eee62/thinpowebank/enclosure/img/c70_v3_front.png

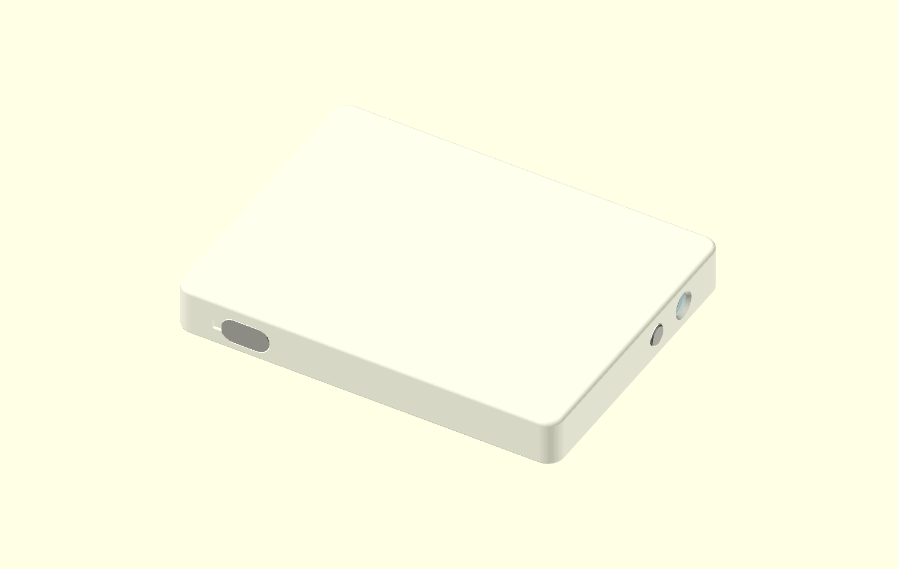
enclosure/img/c70_v3_front.png
