eee62/thinpowebank/enclosure/stl/c70_v3_usb_cover_C.stl

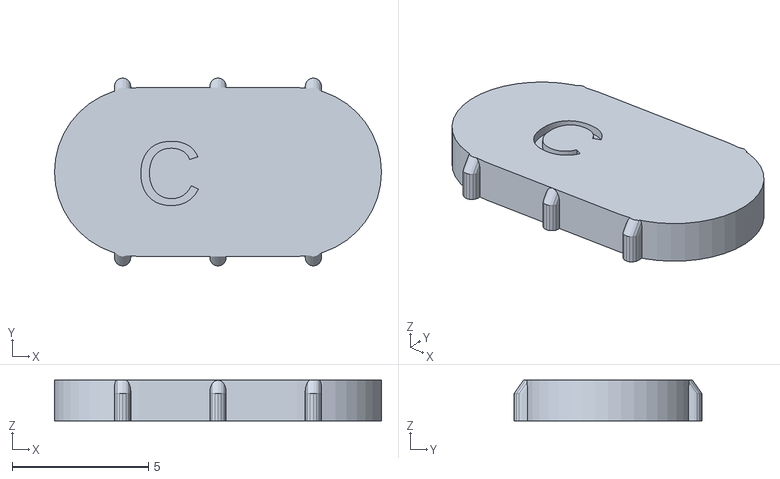
[picture p23: CAD file, 2026-11-07]
enclosure/stl/c70_v3_usb_cover_C.stl
12.0 x 6.90 x 1.50
