eee62/thinpowebank/enclosure/stl/v2/c70_plug_v2_rounded.stl

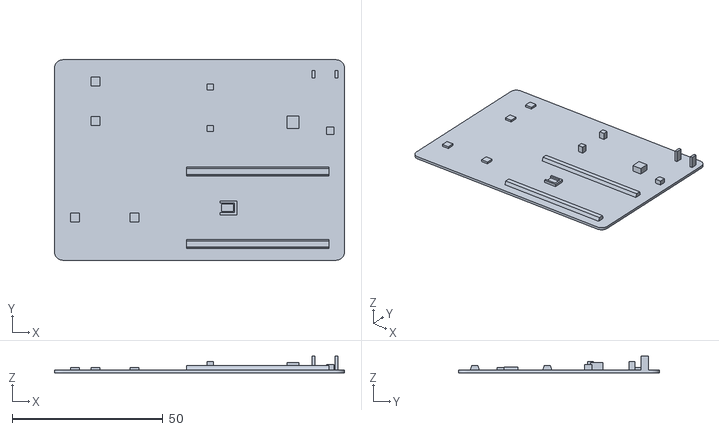
[picture p24: CAD file, 2026-11-06]
enclosure/stl/v2/c70_plug_v2_rounded.stl
96.1 x 66.5 x 5.58
