eee62/thinpowebank/enclosure/stl/c70_v3_plug_v1_sharp_removable.stl

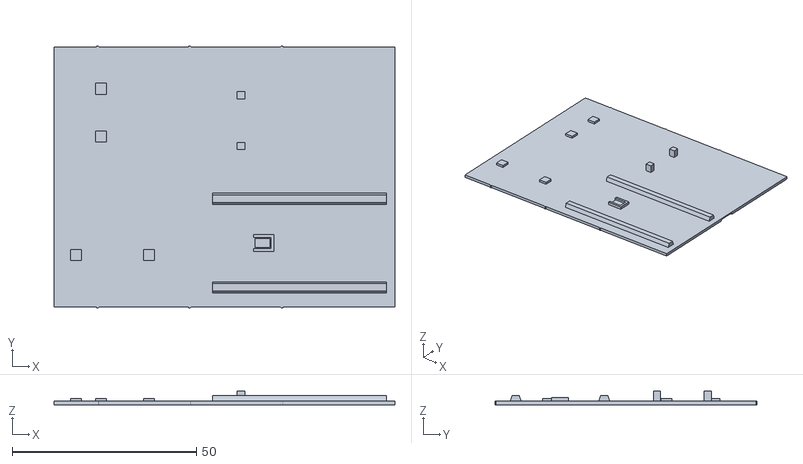
[picture p26: CAD file, 2026-11-07]
enclosure/stl/c70_v3_plug_v1_sharp_removable.stl
92.5 x 71.2 x 3.75
