eee62/thinpowebank/enclosure/stl/v2/c70_wifi_test.stl

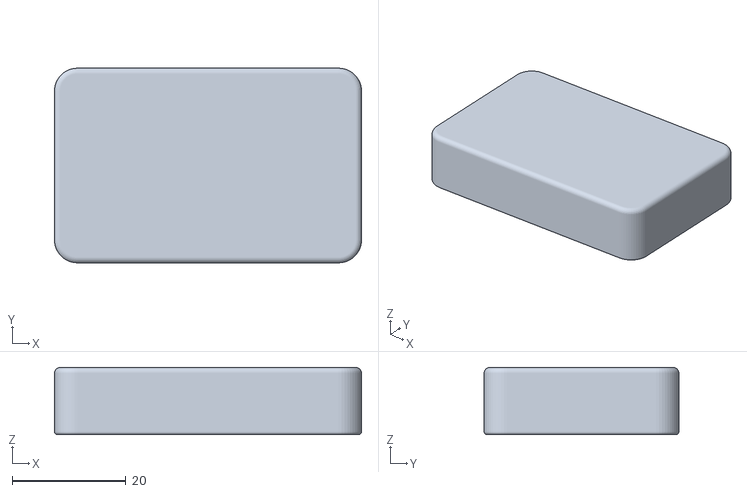
[picture p27: CAD file, 2026-11-06]
enclosure/stl/v2/c70_wifi_test.stl
53.9 x 34.2 x 11.8
