eee62/thinpowebank/enclosure/stl/c70_v3_body_v1_sharp.stl

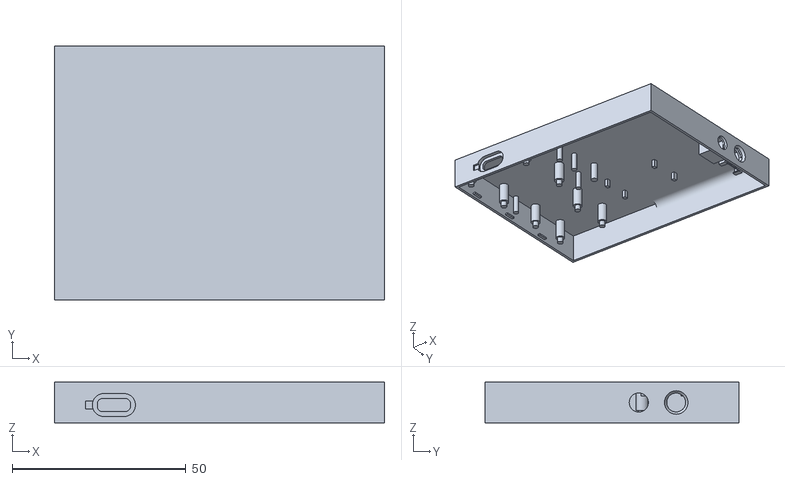
[picture p28: CAD file, 2026-11-07]
enclosure/stl/c70_v3_body_v1_sharp.stl
94.8 x 73.0 x 11.8
