eee62/thinpowebank/enclosure/stl/v2/c70_usb_cover_B.stl

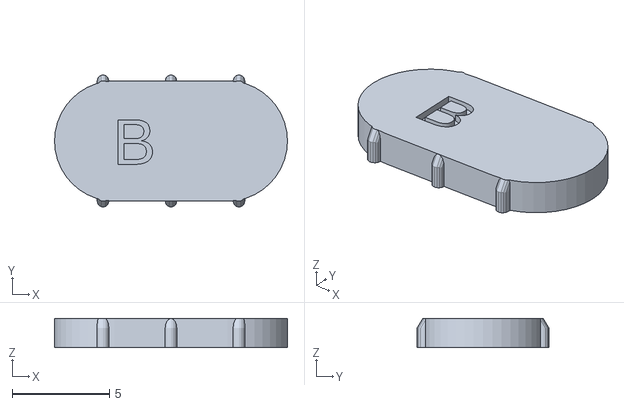
[picture p29: CAD file, 2026-11-06]
enclosure/stl/v2/c70_usb_cover_B.stl
12.0 x 6.80 x 1.50
