eee62/thinpowebank/enclosure/stl/c70_v3_plug_v2_rounded.stl

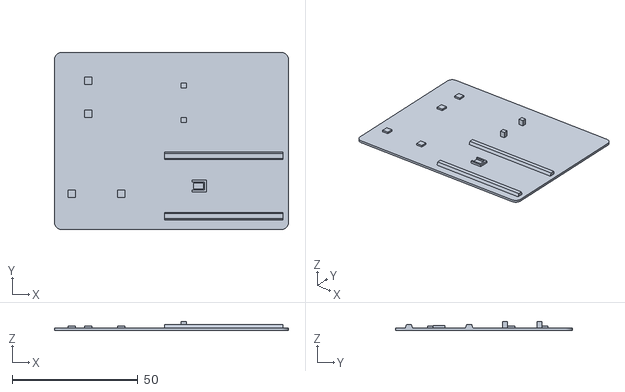
[picture p30: CAD file, 2026-11-07]
enclosure/stl/c70_v3_plug_v2_rounded.stl
93.2 x 70.5 x 3.75
