eee62/thinpowebank/enclosure/stl/v2/c70_wifi_test_plug.stl

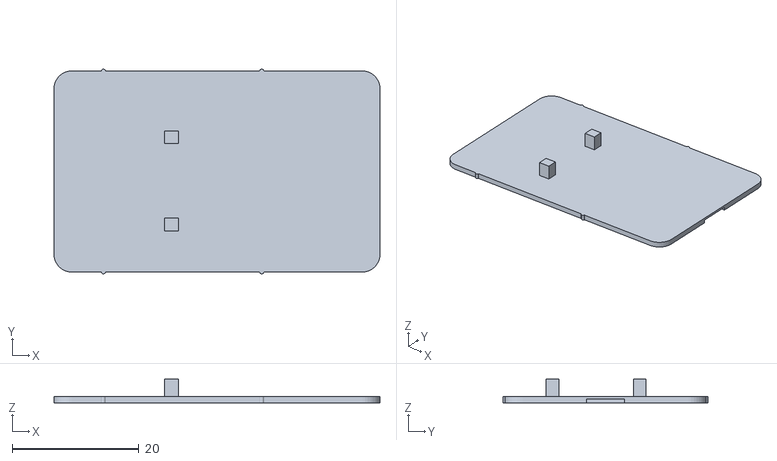
[picture p31: CAD file, 2026-11-06]
enclosure/stl/v2/c70_wifi_test_plug.stl
51.5 x 32.3 x 3.75
