eee62/thinpowebank/enclosure/stl/c70_v3_wifi_test.stl

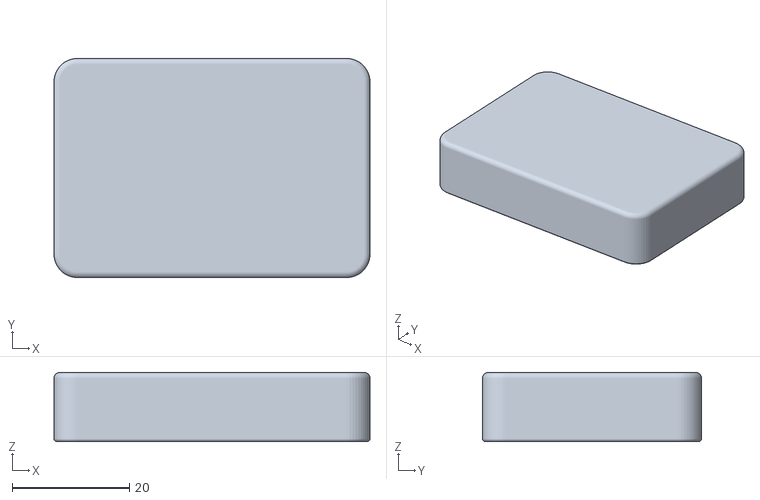
[picture p32: CAD file, 2026-11-07]
enclosure/stl/c70_v3_wifi_test.stl
53.9 x 37.3 x 11.8
