eee62/thinpowebank/enclosure/stl/c70_v3_wifi_test_plug.stl

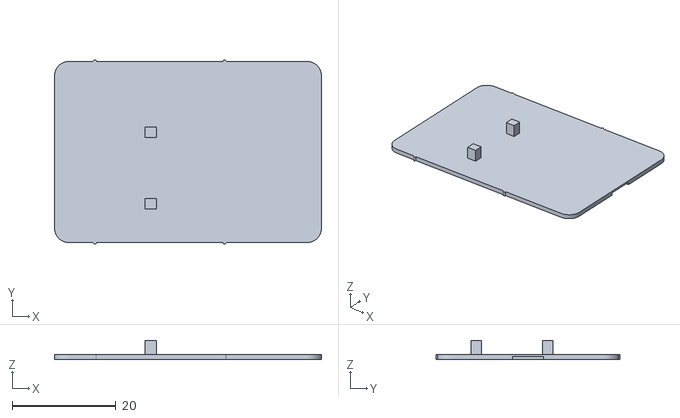
[picture p34: CAD file, 2026-11-07]
enclosure/stl/c70_v3_wifi_test_plug.stl
51.5 x 35.5 x 3.75
