eee62/thinpowebank/enclosure/stl/v2/c70_plug_v1_sharp_removable.stl

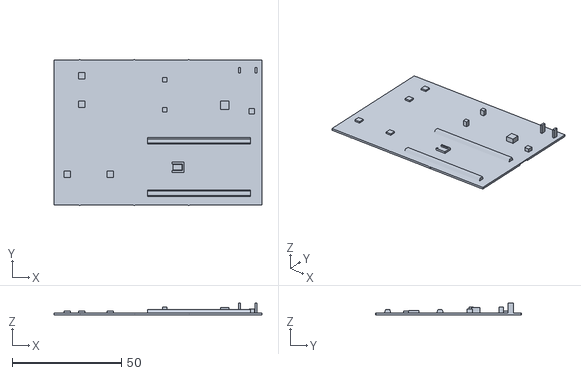
[picture p35: CAD file, 2026-11-06]
enclosure/stl/v2/c70_plug_v1_sharp_removable.stl
95.3 x 67.1 x 5.58
