eee62/thinpowebank/enclosure/stl/c70_v3_body_v2_rounded.stl

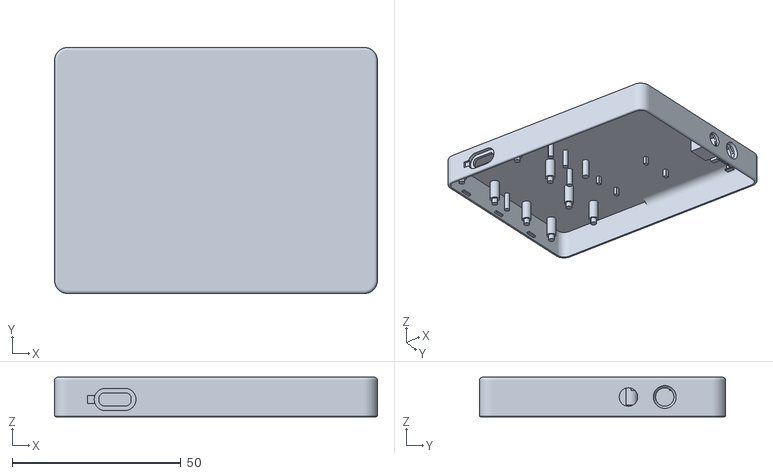
[picture p36: CAD file, 2026-11-07]
enclosure/stl/c70_v3_body_v2_rounded.stl
95.7 x 73.0 x 11.8
