eee62/thinpowebank/enclosure/stl/v2/c70_plug_v1_sharp.stl

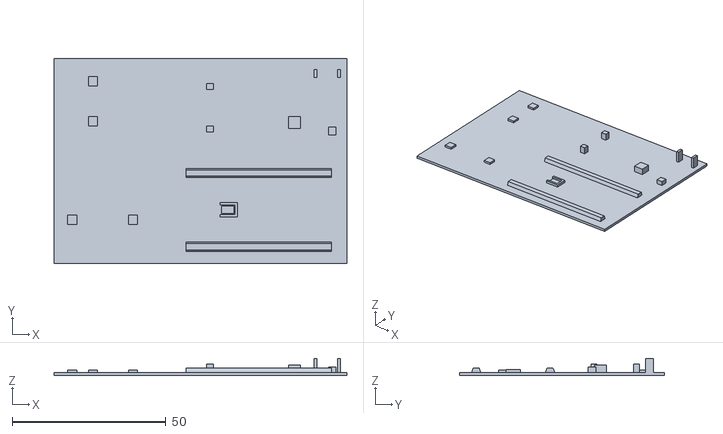
[picture p37: CAD file, 2026-11-06]
enclosure/stl/v2/c70_plug_v1_sharp.stl
95.2 x 66.5 x 5.58
