eee62/thinpowebank/enclosure/stl/c70_v3_button_cap.stl

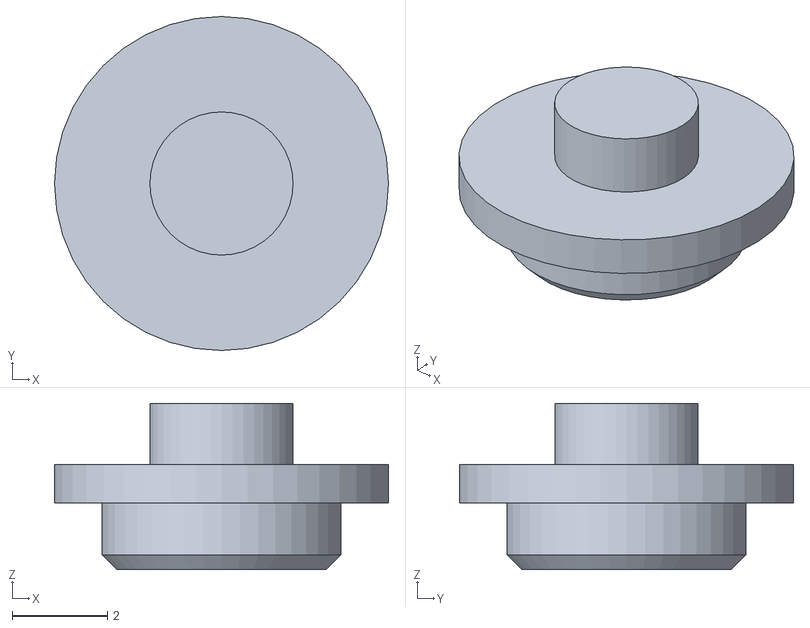
[picture p38: CAD file, 2026-11-07]
enclosure/stl/c70_v3_button_cap.stl
7.00 x 7.00 x 3.48
