eee62/thinpowebank/enclosure/stl/c70_v3_plug_v2_rounded_removable.stl

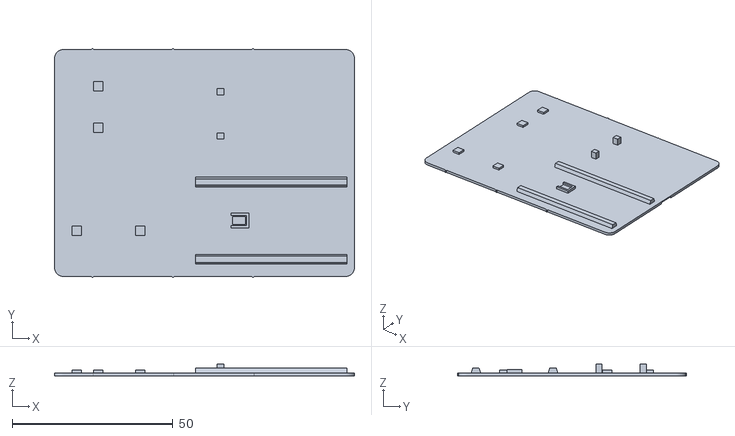
[picture p40: CAD file, 2026-11-07]
enclosure/stl/c70_v3_plug_v2_rounded_removable.stl
93.3 x 71.2 x 3.75
