eee62/thinpowebank/enclosure/stl/v2/c70_usb_cover_A.stl

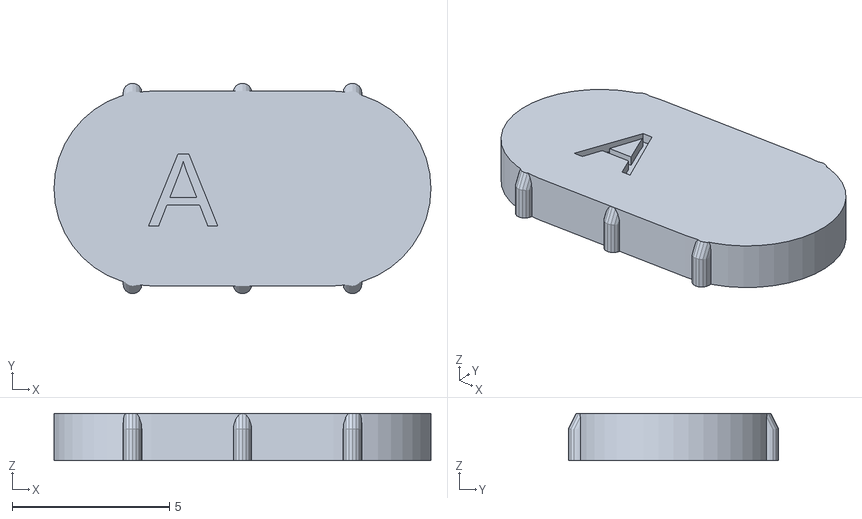
[picture p41: CAD file, 2026-11-06]
enclosure/stl/v2/c70_usb_cover_A.stl
12.0 x 6.70 x 1.50
