eee62/thinpowebank/enclosure/stl/c70_v3_plug_v1_sharp.stl

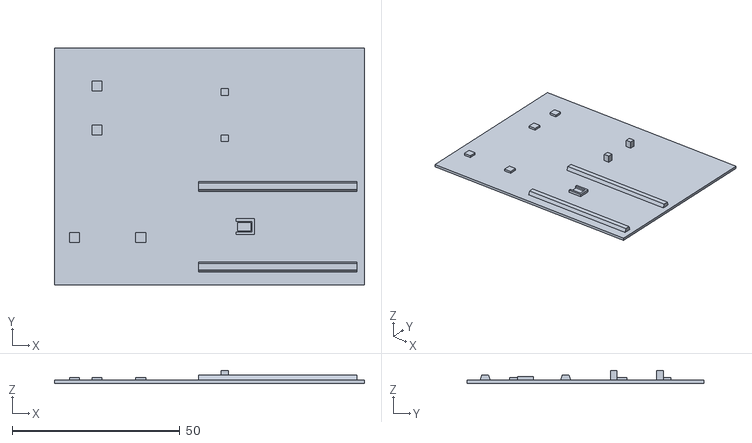
[picture p42: CAD file, 2026-11-07]
enclosure/stl/c70_v3_plug_v1_sharp.stl
92.3 x 70.5 x 3.75
