eee62/thinpowebank/enclosure/stl/v2/c70_fit_coupon.stl

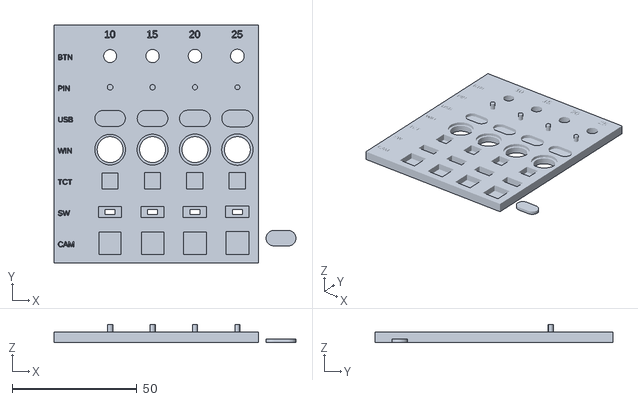
[picture p43: CAD file, 2026-11-06]
enclosure/stl/v2/c70_fit_coupon.stl
97.0 x 95.5 x 7.29
