eee62/thinpowebank/enclosure/stl/v2/c70_body_v2_rounded.stl

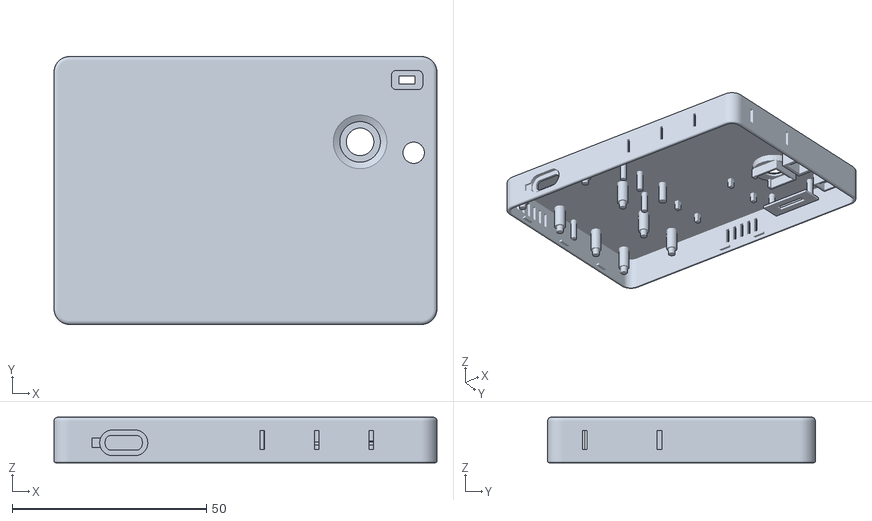
[picture p44: CAD file, 2026-11-06]
enclosure/stl/v2/c70_body_v2_rounded.stl
98.6 x 69.0 x 11.8
