eee62/thinpowebank/enclosure/stl/v2/c70_button_cap.stl

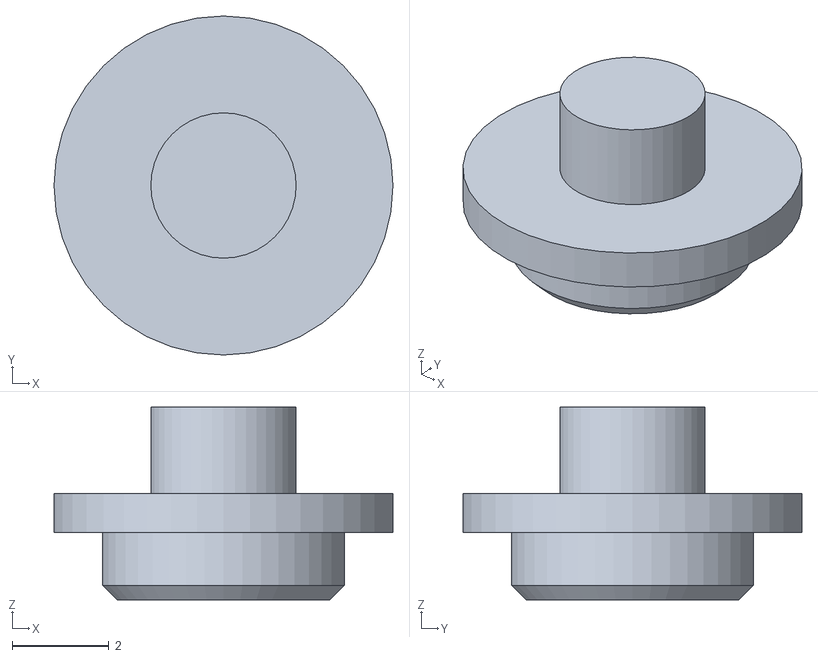
[picture p45: CAD file, 2026-11-06]
enclosure/stl/v2/c70_button_cap.stl
7.00 x 7.00 x 3.98
