eee62/thinpowebank/enclosure/stl/c70_v3_fallback_body_ceramic13x5.stl

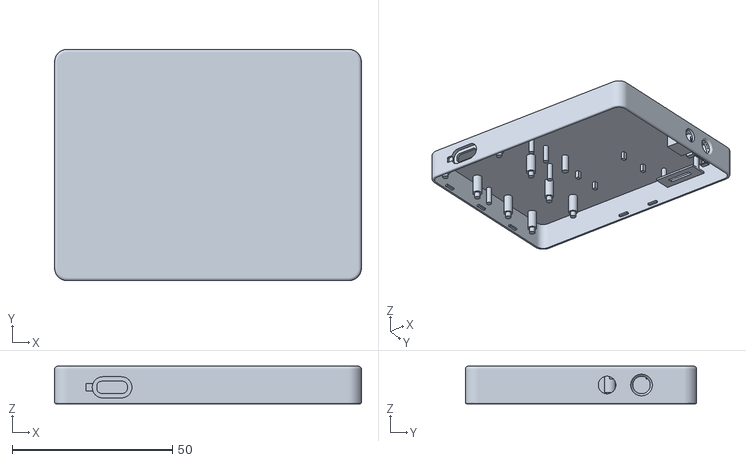
[picture p46: CAD file, 2026-11-07]
enclosure/stl/c70_v3_fallback_body_ceramic13x5.stl
95.7 x 72.2 x 11.8
