eee62/thinpowebank/enclosure/stl/v2/c70_tab_plug_v2_rounded_removable.stl

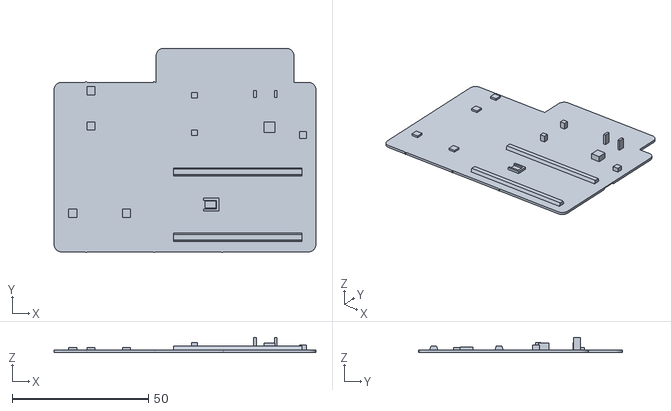
[picture p47: CAD file, 2026-11-06]
enclosure/stl/v2/c70_tab_plug_v2_rounded_removable.stl
96.2 x 75.1 x 5.58
