eee62/thinpowebank/enclosure/stl/button_cap.stl

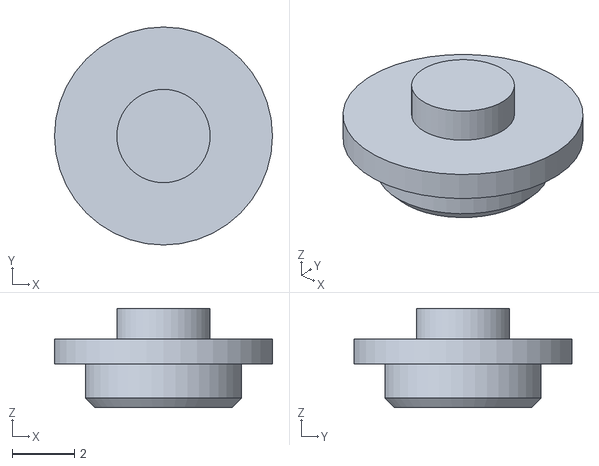
[picture p48: CAD file, 2026-11-05]
enclosure/stl/button_cap.stl
7.00 x 7.00 x 3.18
