eee62/thinpowebank/enclosure/stl/v2/c70_tab_body_v2_rounded.stl

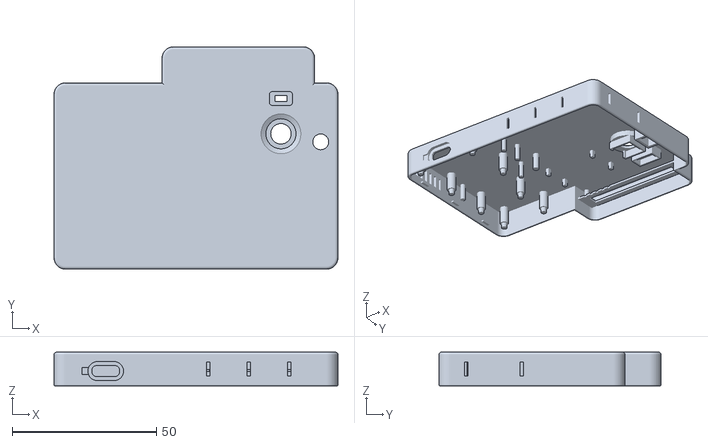
[picture p49: CAD file, 2026-11-06]
enclosure/stl/v2/c70_tab_body_v2_rounded.stl
98.6 x 77.2 x 11.8
