eee62/thinpowebank/enclosure/stl/plug_v2_rounded_rcy_edge.stl

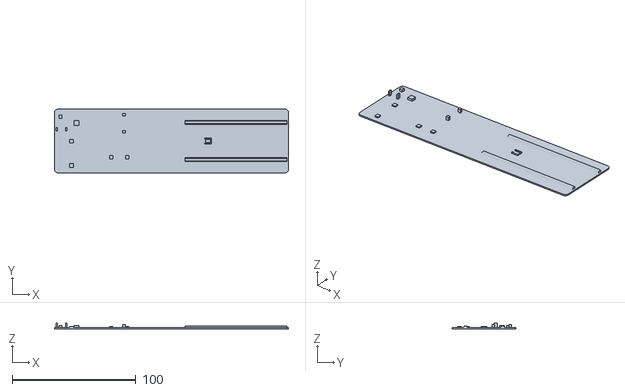
[picture p50: CAD file, 2026-11-05]
enclosure/stl/plug_v2_rounded_rcy_edge.stl
188.9 x 51.6 x 4.78
