eee62/thinpowebank/enclosure/stl/v2/c70_tab_plug_v1_sharp_removable.stl

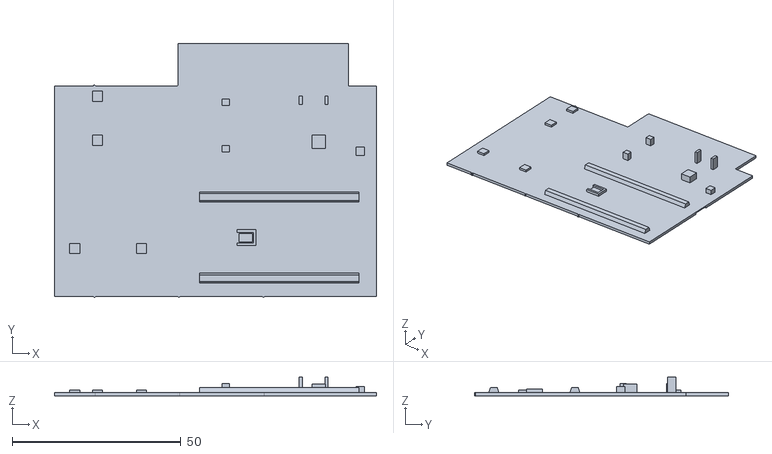
[picture p51: CAD file, 2026-11-06]
enclosure/stl/v2/c70_tab_plug_v1_sharp_removable.stl
95.3 x 75.1 x 5.58
