eee62/thinpowebank/enclosure/stl/plug_v1_sharp_removable.stl

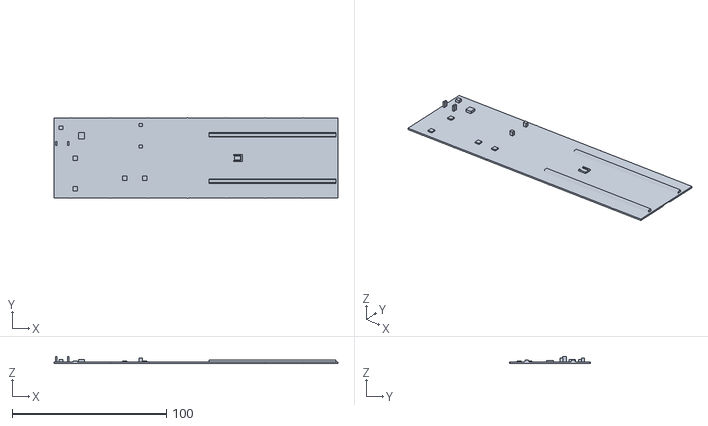
[picture p52: CAD file, 2026-11-05]
enclosure/stl/plug_v1_sharp_removable.stl
183.9 x 52.2 x 4.78
