eee62/thinpowebank/enclosure/stl/v2/c70_tab_body_v1_sharp.stl

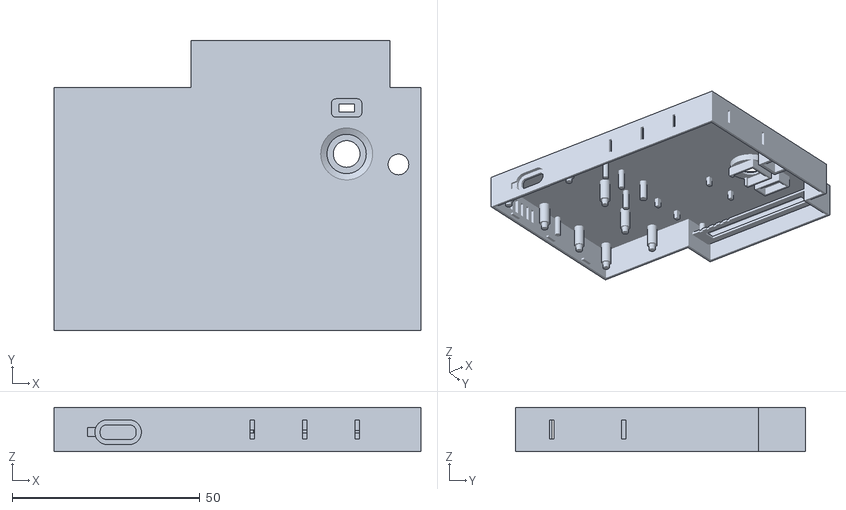
[picture p53: CAD file, 2026-11-06]
enclosure/stl/v2/c70_tab_body_v1_sharp.stl
97.7 x 77.2 x 11.8
