eee62/thinpowebank/enclosure/stl/body_v1_sharp.stl

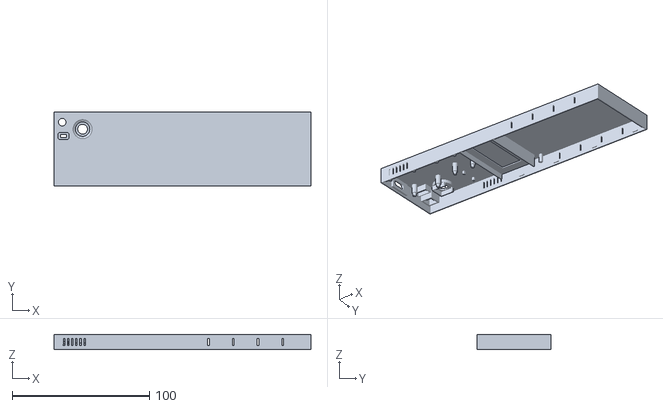
[picture p54: CAD file, 2026-11-05]
enclosure/stl/body_v1_sharp.stl
187.0 x 54.1 x 11.0
