eee62/thinpowebank/enclosure/stl/body_v2_rounded_rcy_edge.stl

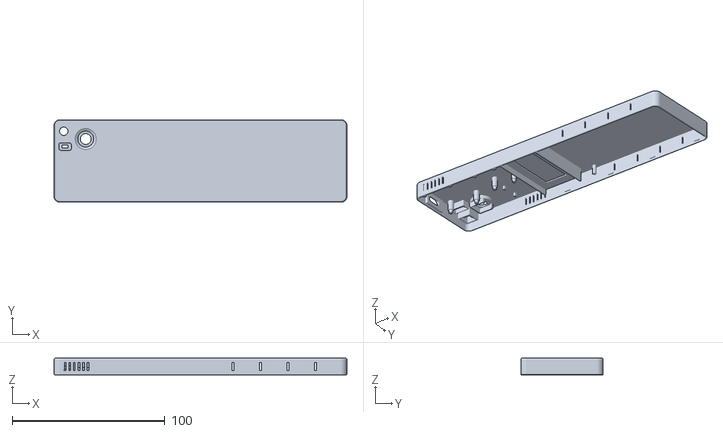
[picture p55: CAD file, 2026-11-05]
enclosure/stl/body_v2_rounded_rcy_edge.stl
192.1 x 54.1 x 11.0
