eee62/thinpowebank/(list of files, cad)

Other CAD files:
enclosure/stl/c70_v3_usb_cover_B.stl
enclosure/stl/v2/c70_usb_cover_C.stl
enclosure/stl/c70_v3_fit_coupon.stl
enclosure/stl/c70_v3_usb_cover_A.stl
enclosure/stl/v2/c70_tab_plug_v2_rounded.stl
enclosure/stl/plug_v2_rounded_removable.stl
enclosure/stl/usb_cover_A.stl
enclosure/stl/plug_v2_rounded.stl
enclosure/stl/usb_cover_B.stl
enclosure/stl/usb_cover_C.stl
enclosure/stl/fit_coupon.stl
enclosure/stl/plug_v1_sharp.stl
enclosure/stl/body_v2_rounded.stl
enclosure/stl/plug_v2_rounded_rcy_edge_removable.stl
