eee62/thinpowebank/reference/measurements.txt

# Raw measurement output (generated 2026-11-04 with tools/*.py; see enclosure/README.md for the interpretation)

## XIAO ESP32-S3 Sense STEP (reference/XIAO_ESP32S3_Sense.step): assembly tree, exact OCC bounding boxes, file coordinates (mm)
XIAO-ESP32S3-Sense v24                   x[  -8.973,  15.390] y[  -0.250,  13.710] z[ -15.001,   2.779]  size 24.363 x 13.960 x 17.780
  Seeed Studio XIAO-ESP32-S3 (Sense)       x[  -8.673,  13.809] y[  -0.250,   4.210] z[ -15.001,   2.779]  size 22.482 x 4.460 x 17.780
    USB TYPE C PORT                          x[   5.909,  13.809] y[   0.010,   4.210] z[ -10.589,  -1.649]  size 7.900 x 4.200 x 8.940
    Shield                                   x[  -5.028,   5.572] y[   0.300,   3.000] z[ -12.411,   0.189]  size 10.600 x 2.700 x 12.600
    SKTAAAE010 v1                            x[   9.164,  12.254] y[   1.000,   1.730] z[ -12.845, -11.245]  size 3.090 x 0.730 x 1.600
    SKTAAAE010 v1                            x[   9.146,  12.236] y[   1.000,   1.730] z[  -0.987,   0.613]  size 3.090 x 0.730 x 1.600
    U.FL-R-SMT-1_10_ v1                      x[  -8.452,  -5.452] y[   1.000,   2.250] z[ -12.388,  -9.288]  size 3.000 x 1.250 x 3.100
    DF40C-30DP-0.4V_51_ v1                   x[  -8.407,  -5.437] y[   1.000,   2.140] z[  -7.723,  -0.203]  size 2.970 x 1.140 x 7.520
    SOLID                                    x[  -8.673,  12.282] y[  -0.250,   1.000] z[ -15.001,   2.779]  size 20.955 x 1.250 x 17.780
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
  JSTPH2_BATT                              x[   4.432,  12.332] y[  11.464,  20.064] z[   1.570,   6.370]  size 7.900 x 8.600 x 4.800
  TDFN8_2X2MM                              x[  11.699,  13.701] y[   7.509,   9.509] z[   1.570,   1.970]  size 2.002 x 2.000 x 0.400

## Adafruit Eagle boards (outline layer 20, holes, parts; board frame, mm)
### dl/Adafruit-bq25185-Charger-Breakout-PCB/Adafruit bq25185 Breakout rev B1.brd
OUTLINE x 0.000..31.750 (31.750)  y 0.000..25.400 (25.400)
  outline curve {'x1': '31.75', 'y1': '2.54', 'x2': '29.21', 'y2': '0', 'width': '0', 'layer': '20', 'curve': '-90'}
CHG        CHIPLED_0805_NOOUTLINE         ORANGE                       at (7.493, 22.733) R270 bbox x 5.84..9.14 y 22.13..23.33
FAULT      CHIPLED_0805_NOOUTLINE         RED                          at (23.495, 22.860) R270 bbox x 21.85..25.14 y 22.26..23.46
R1         0603-NO                        1K                           at (7.747, 21.209) R0 bbox x 6.27..9.22 y 20.48..21.94
R2         0603-NO                        1K                           at (23.495, 21.336) R0 bbox x 22.02..24.97 y 20.61..22.06
VSYSOK     CHIPLED_0805_NOOUTLINE         GREEN                        at (20.733, 15.637) R270 bbox x 19.08..22.38 y 15.04..16.24
R3         0603-NO                        1K                           at (23.257, 13.748) R270 bbox x 22.53..23.99 y 12.27..15.22
C2         0805-NO                        22uF                         at (12.160, 15.478) R270 bbox x 11.41..12.91 y 13.91..17.05
U$11       MOUNTINGHOLE_2.5_PLATED        MOUNTINGHOLE2.5              at (29.210, 2.540) R0 bbox x 26.71..31.71 y 0.04..5.04
U$16       MOUNTINGHOLE_2.5_PLATED        MOUNTINGHOLE2.5              at (29.210, 22.860) R0 bbox x 26.71..31.71 y 20.36..25.36
U$18       MOUNTINGHOLE_2.5_PLATED        MOUNTINGHOLE2.5              at (2.540, 22.860) R0 bbox x 0.04..5.04 y 20.36..25.36
U$19       MOUNTINGHOLE_2.5_PLATED        MOUNTINGHOLE2.5              at (2.540, 2.540) R0 bbox x 0.04..5.04 y 0.04..5.04
VBAT       JSTPH2_BATT                    JST2PH                       at (11.430, 5.080) R180 bbox x 6.33..16.53 y 0.68..9.68
VSYS       JSTPH2_BATT                    JST2PH                       at (20.320, 5.080) R180 bbox x 15.22..25.42 y 0.68..9.68
X3         USB_C_CUSB31-CFM2AX-01-X       USBC                         at (15.875, 21.336) R180 bbox x 10.96..20.80 y 18.49..26.42
IC1        WSON10                         BQ25185                      at (15.875, 12.700) R90 bbox x 14.82..16.93 y 11.55..13.85
R6         0603-NO                        10K                          at (17.653, 11.811) R270 bbox x 16.92..18.38 y 10.34..13.28
C3         0805-NO                        22uF                         at (20.574, 12.446) R0 bbox x 19.00..22.14 y 11.70..13.20
C4         0805-NO                        22uF                         at (11.557, 11.938) R0 bbox x 9.99..13.13 y 11.19..12.69
R5         0603-NO                        10K                          at (9.271, 19.050) R180 bbox x 7.80..10.74 y 18.32..19.78
JP7        1X06_ROUND_76                                               at (3.175, 12.700) R270 bbox x 2.17..4.18 y 5.35..20.32
JP1        1X06_OVALWAVE                                               at (28.575, 12.700) R270 bbox x 27.77..29.38 y 5.55..20.32
R4         0603-NO                        5.1K                         at (13.843, 15.367) R90 bbox x 13.11..14.57 y 13.89..16.84
R7         0603-NO                        5.1K                         at (17.653, 15.748) R90 bbox x 16.92..18.38 y 14.27..17.22
SJ1        SOLDERJUMPER_CLOSEDWIRE                                     at (6.096, 19.050) R180 bbox x 4.45..7.75 y 18.03..20.07
R8         0603-NO                        13K                          at (8.509, 16.637) R270 bbox x 7.78..9.24 y 15.16..18.11
SJ2        SOLDERJUMPER_CLOSEDWIRE                                     at (6.096, 16.510) R180 bbox x 4.45..7.75 y 15.49..17.53
SJ3        SOLDERJUMPER_CLOSEDWIRE                                     at (6.096, 13.970) R0 bbox x 4.45..7.75 y 12.95..14.99
R9         0603-NO                        600                          at (8.509, 13.462) R90 bbox x 7.78..9.24 y 11.99..14.94
R10        0603-NO                        300                          at (6.096, 12.065) R0 bbox x 4.62..7.57 y 11.34..12.79
R11        0603-NO                        1200                         at (6.096, 10.541) R0 bbox x 4.62..7.57 y 9.81..11.27
SJ4        SOLDERJUMPER_ARROW_NOPASTE                                  at (6.096, 12.446) MR180 bbox x 4.45..7.75 y 11.43..13.46
SJ5        SOLDERJUMPER_ARROW_NOPASTE                                  at (6.096, 10.160) MR180 bbox x 4.45..7.75 y 9.14..11.18
R12        0603-NO                        5.1K                         at (6.096, 9.017) R0 bbox x 4.62..7.57 y 8.29..9.75
SJ6        SOLDERJUMPER_ARROW_NOPASTE                                  at (6.096, 7.874) MR180 bbox x 4.45..7.75 y 6.86..8.89
D2         SOD-123FL                      MBRX120                      at (20.574, 17.272) R180 bbox x 18.48..22.67 y 16.45..18.10
D1         SOD-123FL                      MBRX120                      at (23.622, 17.526) R90 bbox x 22.80..24.45 y 15.43..19.62
### dl/Adafruit-MAX17048-PCB/Adafruit-MAX17048-STEMMA.brd
OUTLINE x 0.000..25.400 (25.400)  y 0.000..20.320 (20.320)
  outline curve {'x1': '0', 'y1': '2.54', 'x2': '2.54', 'y2': '0', 'width': '0', 'layer': '20', 'curve': '90'}
PLAIN HOLE x=2.540 y=17.780 d=2.54 (rel 2.540,17.780)
PLAIN HOLE x=22.860 y=17.780 d=2.54 (rel 22.860,17.780)
C1         0603-NO                        1uF                          at (8.382, 9.906) R180 bbox x 6.91..9.86 y 9.18..10.64
R3         RESPACK_4X0603                 10K                          at (8.382, 7.112) R90 bbox x 6.98..9.78 y 5.21..9.01
JP1        1X06_ROUND_70                                               at (12.700, 2.540) R0 bbox x 5.08..20.05 y 1.54..3.54
CONN3      JST_SH4                        STEMMA_I2C_QT                at (22.797, 8.890) R90 bbox x 19.98..24.88 y 5.19..12.59
CONN4      JST_SH4                        STEMMA_I2C_QT                at (2.603, 8.890) R270 bbox x 0.52..5.42 y 5.19..12.59
U$19       MOUNTINGHOLE_2.5_PLATED        MOUNTINGHOLE2.5              at (2.540, 2.540) R0 bbox x 0.04..5.04 y 0.04..5.04
U$21       MOUNTINGHOLE_2.5_PLATED        MOUNTINGHOLE2.5              at (22.860, 2.540) R0 bbox x 20.36..25.36 y 0.04..5.04
U$30       STEMMAQT                                                    at (22.479, 4.445) MR90 
U$31       STEMMAQT                                                    at (2.921, 13.335) MR270 
D1         CHIPLED_0603_NOOUTLINE         GREEN                        at (2.667, 13.208) R270 bbox x 1.52..3.82 y 12.81..13.61
X1         JSTPH2_BATT                    JST 2 PH                     at (17.018, 16.764) R0 bbox x 11.92..22.12 y 10.76..19.76
X2         JSTPH2_BATT                    JST 2 PH                     at (8.382, 16.764) R0 bbox x 3.28..13.48 y 10.76..19.76
SJ1        SOLDERJUMPER_CLOSEDWIRE                                     at (3.302, 14.732) MR180 bbox x 1.65..4.95 y 13.72..15.75
R2         0603-NO                        10K                          at (16.129, 7.493) R0 bbox x 14.66..17.60 y 6.76..8.22
X3         TDFN8_2X2MM                    MAX17048/T                   at (12.700, 8.509) R0 bbox x 11.20..14.20 y 7.41..9.61
SJ2        SOLDERJUMPER_2WAY_OPEN_NOPASTE                              at (12.827, 9.271) MR0 bbox x 10.54..15.11 y 8.26..10.29
JP2        1X02_ROUND                                                  at (12.700, 11.430) R0 bbox x 10.16..14.97 y 10.43..12.43
C2         0603-NO                        1uF                          at (17.653, 9.017) R180 bbox x 16.18..19.13 y 8.29..9.75

## Seeed DXF outlines (layer 20 = board outline, centre line of the drawn wire)
### pdf/xiao_dim.dxf
  layer 20                   n=  26  x[-0.640,17.150] y[13.150,34.295]  size 17.790 x 21.145
### pdf/expboard_top.dxf
  layer 20                   n=  24  x[-0.685,17.195] y[12.523,27.990]  size 17.880 x 15.467
