eee62/thinpowebank/(commit log)

2026-11-04 Enclosure: parametric OpenSCAD model, checks, STEP/Eagle measurement tools
    Claude-Session: https://claude.ai/code/session_01MdsTeiaHpybnkTSVdv7R2P
    [XIAO_ESP32S3_Sense.step, powerbank.scad]
2026-11-04 Enclosure: README with checked dimensions, fits, sizes; preview images; rounded cell stops
    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
    [powerbank.scad]
2026-11-04 Fix variant collisions found by the checks (front port, small bay, SD card, removable plug check); add check logs
    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
    [powerbank.scad]
2026-11-05 Layout 3: connectors kept with finger access, antenna bay with 5 mm keep-out; layout studies 1 and 2
    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
    [layout_studies.scad, powerbank.scad]
2026-11-05 Layout 3 chosen: STLs, layout comparison, check logs, README update
    - connectors kept with finger access from the back (10 access checks)
    - antenna bay with >= 5 mm metal keep-out, wire shelf, fences (10 keep-out checks)
    - layout studies 1 and 2 as lower-bound placement models (42 checks each)
    - STLs for v1/v2 body and plug (permanent + removable), covers A/B/C, cap, coupon
    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
    [body_v1_sharp.stl, body_v2_rounded.stl, button_cap.stl, fit_coupon.stl, layout_studies.scad, plug_v1_sharp.stl, plug_v1_sharp_removable.stl, plug_v2_rounded.stl]
2026-11-05 Real JST-PH plug zones, RCY splice option, antenna hung off the walls, corrected cell-lead route
    - plug zones from the real PH housing (5.8 x 4.5 x 6.35, 2.0 mm mated protrusion); row gap 16 -> 14.2 mm, length 188.9 -> 187.1
    - cell_connector=RCY option: 23.3 x 6.7 x 4.0 splice in the lead zone with finger columns (+5.0 mm on edge, +7.7 flat)
    - antenna on a frame at mid-height, 4.4 mm from front wall and plug (Seeed staff: 3-5 mm), 5 mm keep-out kept
    - cell-lead route moved to the +Y lane: the old route over the MAX17048 was blocked
    - 14 new check pairs (lanes vs components, bq zones, splice): 81/81 pass in 5 configurations
    - cell-bay relief slots, README sections 6-8 (connectors, Wi-Fi revie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
    [body_v1_sharp.stl, body_v2_rounded.stl, body_v2_rounded_rcy_edge.stl, button_cap.stl, fit_coupon.stl, plug_v1_sharp.stl, plug_v1_sharp_removable.stl, plug_v2_rounded.stl]
2026-11-05 Compact 70 x 100 x 12 mm version: swap-in part parameters, cell x antenna table, shopping spec
    - powerbank70.scad: one layout driven by cell, antenna, slide-switch and button size
    parameters at the top; asserts name the dimension that fails; hard limits are checked
    at the worst-case printed size (nominal + 0.2 mm), strict 6.0 mm button rule,
    antenna cable straight-line check.
    - Default (603450 + ceramic 15x5): 99.80 x 68.96 x 11.78 mm nominal, 99.996 x 69.16 x
    11.98 worst case. Stick-on antennas fit only with a 503040-class cell.
    - 82/82 collision pairs pass in 13 configurations; STLs, logs and size-limit evidence added.
    - tools/run_combos.sh: cell x antenna table. run_checks.sh hono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
    [c70_body_v1_sharp.stl, c70_body_v2_rounded.stl, c70_button_cap.stl, c70_fit_coupon.stl, c70_plug_v1_sharp.stl, c70_plug_v1_sharp_removable.stl, c70_plug_v2_rounded.stl, c70_plug_v2_rounded_removable.stl]
2026-11-06 Antenna tab study: stick-on antennas outside the 70 x 100 footprint (ceramic stays default)
    - powerbank70.scad: ant_place ("inside" default | "tab_x" | "tab_y"), ant_rot, ant_tab_pos,
    tab_budget, smalls_place. The tab position is found by scanning the edge against every
    metal part and wire lane (cell foil 10 mm, everything else 5 mm); the tab shares the main
    cavity and the plug gets a matching lobe. 11 new tab-cavity pairs (93 in total).
    - Result for the 603450 cell: smallest tab is on the +Y side above the XIAO:
    25x6 +5.68, 45x7 +7.20, 40x8 +8.20 mm width (within 10 mm); 42x12 +12.20 and 39x19 +19.20 fail.
    Far (+X) end needs >= +13.63 mm (cell-foil rule). 13 mm ceramic inside: no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
    [c70_body_v1_sharp.stl, c70_body_v2_rounded.stl, c70_button_cap.stl, c70_fit_coupon.stl, c70_plug_v2_rounded.stl, c70_plug_v2_rounded_removable.stl, c70_tab_body_v1_sharp.stl, c70_tab_body_v2_rounded.stl]
2026-11-06 Clean rectangle: default ceramic 13x5, Plan B sizes, Wi-Fi test piece; tab code marked unused
    - Default antenna is now the 13 x 5 ceramic inside: 98.60 x 68.96 x 11.78 mm
    (15 x 5 is the longest that still fits, 99.80). README recommended path has no tab.
    - Plan B (whole body grows as a clean rectangle, all antenna rules kept):
    Molex-206994-class 15.4 x 6.4 -> 100.196 x 70.360; stick-on 25 x 6 -> 108.529 x 69.960.
    Molex-class is smaller (7050 vs 7593 mm2). tools/run_planb.py and its output added.
    - Wi-Fi test piece (part = wifi_test / wifi_test_plug): the real walls, XIAO posts, pads and
    antenna frame around the XIAO and the antenna bay, one bay for the ceramic and a stick-on.
    STLs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
    [c70_body_v1_sharp.stl, c70_body_v2_rounded.stl, c70_button_cap.stl, c70_fit_coupon.stl, c70_plug_v1_sharp.stl, c70_plug_v1_sharp_removable.stl, c70_plug_v2_rounded.stl, c70_plug_v2_rounded_removable.stl]
2026-11-07 Test a 50 x 14 x 0.3 FPC antenna on the inner lid / wall surface: FAIL in 70 x 100 x 12
    - tools/run_fpc_inner.py: 3D clearance test (10 mm cell foil, 5 mm other metal and wire lanes), flat or one R3/R5 bend.
    - Result: blocked by lanes/boards/cell on the lid and front wall; best bent placement (+Y wall) short by 2.9 mm
    (switch, then XIAO: needs W >= 72.55). Smallest bodies: 98.6 x 73.2 or 110.6 x 64.7.
    - README section added; ceramic 13 x 5 stays default and fallback. Default build re-checked: 98/98 pairs, 30 asserts.
    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
2026-11-07 Design v3: FPC antenna on the +Y wall, camera and one button on the short end face, no switch, sealed
    - powerbank70.scad: ant_place="wall_fpc" (50x14x0.3 strip on the inner +Y wall, one R3 bend onto the front wall, printed fillet),
    cam_face="end" (camera + button on the +X end face via an end-face frame), has_switch=false, vents=false, cell_vents=false,
    window disc 7 mm / FOV 69 (12 mm disc and 120 deg lens fail the 9.78 mm cavity), tact body 4.3, width follows the XIAO (73.0 nominal = 73.2 worst case).
    - Result: 95.73 x 73.00 x 11.78 mm; 98/98 collision pairs and all asserts pass in 6 configurations (default rounded/sharp/permanent,
    ceramic 13x5 fallback, 603450 at its max size, unuse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
    [c70_body_v1_sharp.stl, c70_body_v2_rounded.stl, c70_button_cap.stl, c70_fit_coupon.stl, c70_plug_v1_sharp.stl, c70_plug_v1_sharp_removable.stl, c70_plug_v2_rounded.stl, c70_plug_v2_rounded_removable.stl]
